Toms42/Monarch-Controller/Project Outputs for Monarch/Monarch-BOM.xlsx

Line # | Name | Description | Designator | Quantity | Qtty Real: | Manufacturer 1 | Manufacturer Part Number 1 | Manufacturer Lifecycle 1 | Supplier 1 | Supplier Part Number 1 | Supplier Unit Price 1 | Supplier Subtotal 1 | Num Boards: | 3
 | CAP 10uF 16V 0805(2012) | CAP 10uF 16V ±10% 0805 (2012 Metric) Thickness 1mm SMD | C1, C4, C5 | 3 | 9 | Murata (https://octopart-clicks.com/click/altium?sku=490-6473-1-ND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) | GRM21BR61C106KE15K (https://octopart-clicks.com/click/altium?sku=490-6473-1-ND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) | Manual Solution | Digi-Key | 490-6473-1-ND (https://octopart-clicks.com/click/altium?sku=490-6473-1-ND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) | 0.216 | 1.944 | Total: | 119.542
 | CAP 2.2uF 16V 0603(1608) | CAP 2.2uF 16V ±10% 0603 (1608 Metric) Thickness 1mm SMD | C2, C7 | 2 | 6 | Murata (https://octopart-clicks.com/click/altium?sku=490-10731-1-ND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) | GRM188R61E225KA12D (https://octopart-clicks.com/click/altium?sku=490-10731-1-ND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) | Manual Solution | Digi-Key | 490-10731-1-ND (https://octopart-clicks.com/click/altium?sku=490-10731-1-ND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) | 0.17 | 1.02
 | CAP 100nF 16V 0402(1005) | CAP 100nF 16V ±10% 0402 (1005 Metric) Thickness 0.6mm SMD | C3, C6, C8, C9, C10 | 5 | 15 | Murata (https://octopart-clicks.com/click/altium?sku=490-10404-1-ND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) | GRM033C81E104ME14D (https://octopart-clicks.com/click/altium?sku=490-10404-1-ND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) | Manual Solution | Digi-Key | 490-10404-1-ND (https://octopart-clicks.com/click/altium?sku=490-10404-1-ND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) | 0.053 | 0.795
 | IHLP-1212BZ | IHLP-1212BZ 2.2uH | L1 | 1 | 3 | Vishay Dale (https://octopart-clicks.com/click/altium?sku=541-1322-1-ND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) | IHLP1212BZER2R2M11 (https://octopart-clicks.com/click/altium?sku=541-1322-1-ND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) | Manual Solution | Digi-Key | 541-1322-1-ND (https://octopart-clicks.com/click/altium?sku=541-1322-1-ND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) | 1.45 | 4.35
 | MSP430FR2433IRGER | MSP430FR2433 16 MHz Ultra-Low-Power Microcontroller with 16 KB FRAM, 4 KB RAM, 19 IO, 4 Timers, RGE0024H (VQFN-24) | MSP1 | 1 | 3 | Texas Instruments (https://octopart-clicks.com/click/altium?manufacturer=Texas%20Instruments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) | MSP430FR2433IRGER (https://octopart-clicks.com/click/altium?manufacturer=Texas%20Instruments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) | Manual Solution | Digi-Key | 296-47810-1-ND (https://octopart-clicks.com/click/altium?manufacturer=Texas%20Instruments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) | 2.46 | 7.38
 | Header 5X2H | Header, 5-Pin, Dual row, Right Angle | P1 | 1 | 3 | 3M (https://octopart-clicks.com/click/altium?sku=3M156384-10-ND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) | 929745-01-05-I (https://octopart-clicks.com/click/altium?sku=3M156384-10-ND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) | Manual Solution | Digi-Key | 3M156384-10-ND (https://octopart-clicks.com/click/altium?sku=3M156384-10-ND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) | 2.72 | 8.16
 | 53261-0471 | Male Header, Pitch 1.25 mm, 1 x 4 Position, Height 3.4 mm, -40 to 85 degC, RoHS, Tape and Reel | P2 | 1 | 3 | Molex (https://octopart-clicks.com/click/altium?sku=WM7622CT-ND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) | 53261-0471 (https://octopart-clicks.com/click/altium?sku=WM7622CT-ND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) | Manual Solution | Digi-Key | WM7622CT-ND (https://octopart-clicks.com/click/altium?sku=WM7622CT-ND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) | 1.24 | 3.72
 | BSS138DW-7-F | Dual N-Channel Enhancement Mode Field Effect Transistor, 50 V, 200 mA, -55 to 150 degC, 6-Pin SOT-363, RoHS, Tape and Reel | Q1 | 1 | 3 | Diodes (https://octopart-clicks.com/click/altium?sku=BSS138DWQ-7DICT-ND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) | BSS138DWQ-7 (https://octopart-clicks.com/click/altium?sku=BSS138DWQ-7DICT-ND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) | Manual Solution | Digi-Key | BSS138DWQ-7DICT-ND (https://octopart-clicks.com/click/altium?sku=BSS138DWQ-7DICT-ND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) | 0.51 | 1.53
 | 10K 1% 0402(1005) | 10K 0.063W 1% 0402 (1005 Metric) SMD | R1 | 1 | 3 | Panasonic (https://octopart-clicks.com/click/altium?sku=P10.0KLCT-ND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) | ERJ-2RKF1002X (https://octopart-clicks.com/click/altium?sku=P10.0KLCT-ND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) | Volume Production | Digi-Key | P10.0KLCT-ND (https://octopart-clicks.com/click/altium?sku=P10.0KLCT-ND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) | 0.1 | 0.3
 | 100K 1% 0402(1005) | 100K 0.063W 1% 0402 (1005 Metric) SMD | R2 | 1 | 3 | Panasonic (https://octopart-clicks.com/click/altium?sku=P100KLCT-ND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) | ERJ-2RKF1003X (https://octopart-clicks.com/click/altium?sku=P100KLCT-ND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) | Volume Production | Digi-Key | P100KLCT-ND (https://octopart-clicks.com/click/altium?sku=P100KLCT-ND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) | 0.1 | 0.3
 | 1K 1% 0402(1005) | 1K 0.063W 1% 0402 (1005 Metric) SMD | R3, R4 | 2 | 6 | Panasonic (https://octopart-clicks.com/click/altium?sku=P1.00KLCT-ND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) | ERJ-2RKF1001X (https://octopart-clicks.com/click/altium?sku=P1.00KLCT-ND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) | Volume Production | Digi-Key | P1.00KLCT-ND (https://octopart-clicks.com/click/altium?sku=P1.00KLCT-ND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) | 0.054 | 0.324
 | 4K53 1% 0402(1005) | 4K53 0.063W 1% 0402 (1005 Metric) SMD | R5 | 1 | 3 | Panasonic (https://octopart-clicks.com/click/altium?sku=P4.53KLCT-ND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) | ERJ-2RKF4531X (https://octopart-clicks.com/click/altium?sku=P4.53KLCT-ND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) | Volume Production | Digi-Key | P4.53KLCT-ND (https://octopart-clicks.com/click/altium?sku=P4.53KLCT-ND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) | 0.1 | 0.3
 | 1K5 1% 0402(1005) | 1K5 0.063W 1% 0402 (1005 Metric) SMD | R6 | 1 | 3 | Panasonic (https://octopart-clicks.com/click/altium?sku=P1.50KLCT-ND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) | ERJ-2RKF1501X (https://octopart-clicks.com/click/altium?sku=P1.50KLCT-ND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) | Volume Production | Digi-Key | P1.50KLCT-ND (https://octopart-clicks.com/click/altium?sku=P1.50KLCT-ND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) | 0.1 | 0.3
 | BNO055 | Intelligent 9-Axis Absolute Orientation Sensor, 1.7 V to 3.6 V, -40 to 85 degC, 28-Pin LGA, RoHS, Tape and Reel | U1 | 1 | 3 | Bosch (https://octopart-clicks.com/click/altium?sku=828-1058-1-ND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) | BNO055 (https://octopart-clicks.com/click/altium?sku=828-1058-1-ND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) | Manual Solution | Digi-Key | 828-1058-1-ND (https://octopart-clicks.com/click/altium?sku=828-1058-1-ND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) | 12.07 | 36.21
 | TI-TPS62172DSG8 |  | U2 | 1 | 3 | Texas Instruments (https://octopart-clicks.com/click/altium?sku=296-39449-1-ND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) | TPS62172DSGR (https://octopart-clicks.com/click/altium?sku=296-39449-1-ND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) | Manual Solution | Digi-Key | 296-39449-1-ND (https://octopart-clicks.com/click/altium?sku=296-39449-1-ND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) | 1.53 | 4.59
 | MPL3115A2 | Xtrinsic I2C Precision Altimeter, 1.95 to 3.6 V, -40 to 85 degC, 8-Pin LGA (2153-01), RoHS, Tray | U3 | 1 | 3 | NXP Freescale (https://octopart-clicks.com/click/altium?sku=MPL3115A2-ND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) | MPL3115A2 (https://octopart-clicks.com/click/altium?sku=MPL3115A2-ND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) | Volume Production | Digi-Key | MPL3115A2-ND (https://octopart-clicks.com/click/altium?sku=MPL3115A2-ND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) | 5.8 | 17.4
 | JTAG 1mm headers | 1mm-pitch pins for temporary jtag header | jtag1 | 1 | 3 | Sullins (https://octopart-clicks.com/click/altium?sku=S9214-ND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) | SMH100-LPSE-S10-ST-BK (https://octopart-clicks.com/click/altium?sku=S9214-ND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) | Manual Solution | Digi-Key | S9214-ND (https://octopart-clicks.com/click/altium?sku=S9214-ND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) | 2.17 | 6.51
 | Non-Scaling:
 | Picoclasp mating connector | Picoclasp connector for radio | pico1, pico2 | 5 | 5 | Molex (https://octopart-clicks.com/click/altium?sku=WM1722-ND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) | 51021-0400 (https://octopart-clicks.com/click/altium?sku=WM1722-ND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) | Manual Solution | Digi-Key | WM1722-ND (https://octopart-clicks.com/click/altium?sku=WM1722-ND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) | 0.37 | 1.85
 | picoclasp crimps | CONN TERM FEMALE 26-28AWG TIN | pcon1, pcon2, pcon3, pcon4, pcon5, pcon6, pcon7, pcon8, pcon9, pcon10, pcon11, pcon12, pcon13, pcon14, pcon15 | 30 | 30 | Molex (https://octopart-clicks.com/click/altium?sku=WM1142CT-ND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) | 50079-8000 (https://octopart-clicks.com/click/altium?sku=WM1142CT-ND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) | Manual Solution | Digi-Key | WM1142CT-ND (https://octopart-clicks.com/click/altium?sku=WM1142CT-ND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) | 0.0462 | 1.386
 | 5x2 housing |  | servc1 | 2 | 2 | Molex (https://octopart-clicks.com/click/altium?sku=WM8037-ND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) | 90142-0010 (https://octopart-clicks.com/click/altium?sku=WM8037-ND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) | Manual Solution | Digi-Key | WM8037-ND (https://octopart-clicks.com/click/altium?sku=WM8037-ND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) | 0.81 | 1.62
 | 1x2 housing |  | ledc1, ledc2, ledc3 | 7 | 7 | Molex (https://octopart-clicks.com/click/altium?sku=WM2800-ND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) | 50-57-9002 (https://octopart-clicks.com/click/altium?sku=WM2800-ND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) | Manual Solution | Digi-Key | WM2800-ND (https://octopart-clicks.com/click/altium?sku=WM2800-ND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) | 0.35 | 2.45
 | .1in contacts |  | scon1, scon2, scon3, scon4, scon5, scon6, scon7, scon8, scon9, scon10, scon11, scon12, scon13, scon14, scon15 | 35 | 35 | Molex (https://octopart-clicks.com/click/altium?sku=WM2581CT-ND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) | 90119-0109 (https://octopart-clicks.com/click/altium?sku=WM2581CT-ND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) | Manual Solution | Digi-Key | WM2581CT-ND (https://octopart-clicks.com/click/altium?sku=WM2581CT-ND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) | 0.1178 | 4.123
 | Solder Paste: | SLDR PASTE NO-CLN SN63/PB37 50G | Paste | 1 | 1 | Chip Quik Inc. | SMD291AX50T3 | (Excel Entry) | Digi-Key | SMD291AX50T3-ND | 12.98 | 12.98
