Toms42/Monarch-Controller/(list of files, drawings)

Other design files:
Monarch.PcbDoc
Monarch.Pcblib
Monarch.PrjPCB
Monarch.SchDoc
Monarch.Schlib
