Toms42/Monarch-Controller/(commit log)

2018-12-12 Second commit
    [Monarch.PcbDoc, Monarch.PrjPCB, Monarch.SchDoc]
2018-12-13 Finished schematics without JTAG and MOSFET sections
    [Monarch.PcbDoc, Monarch.Pcblib, Monarch.SchDoc, Monarch.Schlib]
2018-12-13 Add barometer, route most signals
    [Monarch.PcbDoc, Monarch.Pcblib, Monarch.PrjPCB, Monarch.SchDoc, Monarch.Schlib]
2018-12-13 re-add monarch.schlib. Accidental removal.
    [Monarch.Schlib]
2018-12-13 revise msp footprint to improve grounding
    [Monarch.PcbDoc, Monarch.Pcblib]
2018-12-13 ground all msp pins
    [Monarch.PcbDoc]
2018-12-13 minor routing updates
    [Monarch.PcbDoc]
2018-12-14 Finalized layout
    [Monarch.PcbDoc, Monarch.Pcblib, Monarch.SchDoc, Monarch.Schlib]
2018-12-14 Tented unnecessary vias
    [Monarch.PcbDoc]
2018-12-14 silk and debug pin
    [Monarch.PcbDoc]
2018-12-14 Rendered gerbers
    [Monarch.GBL, Monarch.GBO, Monarch.GBP, Monarch.GBS, Monarch.GKO, Monarch.GM1, Monarch.GTL, Monarch.GTO]
2018-12-16 minor stuff probably
    [Monarch.PcbDoc]
2018-12-16 Fix attempt at 3D modelles
    [Monarch.PcbDoc]
2018-12-16 add activeBOM
    [Monarch.PcbDoc, Monarch.PrjPCB]
2018-12-17 add exported BOM
    [Monarch-BOM.xlsx, Monarch.PrjPCB]
